ianm8/4020/README.md

# 4020
A dual band QRP transceiver for 40m and 20m. This project was described here: https://groups.io/g/qrptech/topic/designing_and_building_a/106295192

Here is a block diagram:

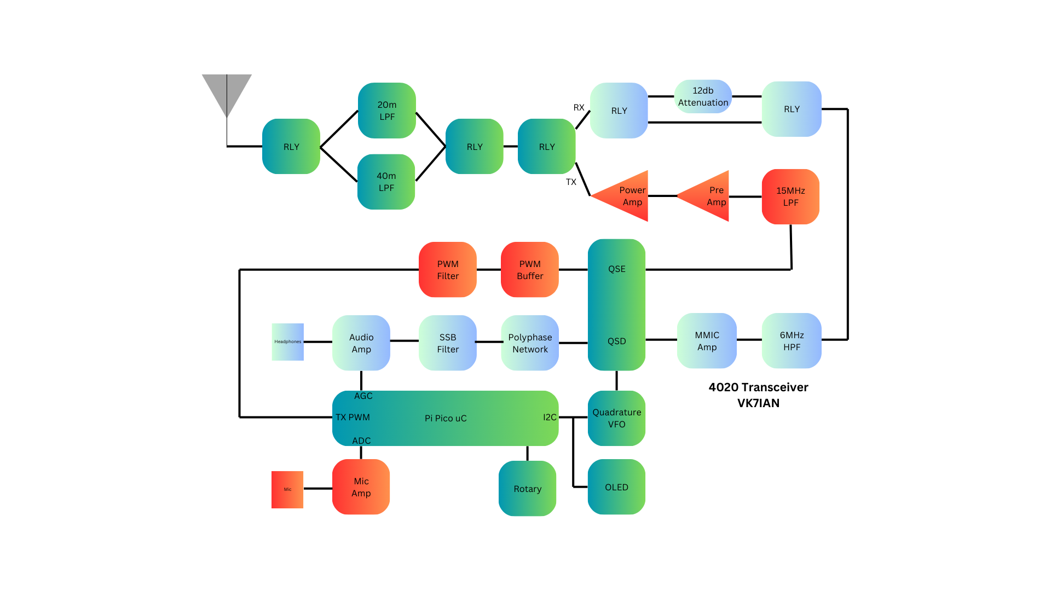
[picture p1: docs/4020-Block-Diagram.png]


And here is a block diagram of the transmit DSP:

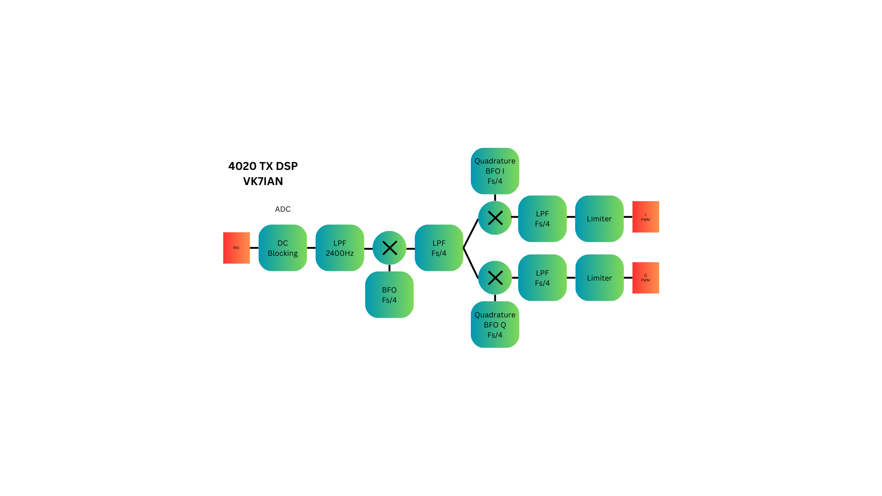
[picture p2: docs/4020 TX DSP.png]


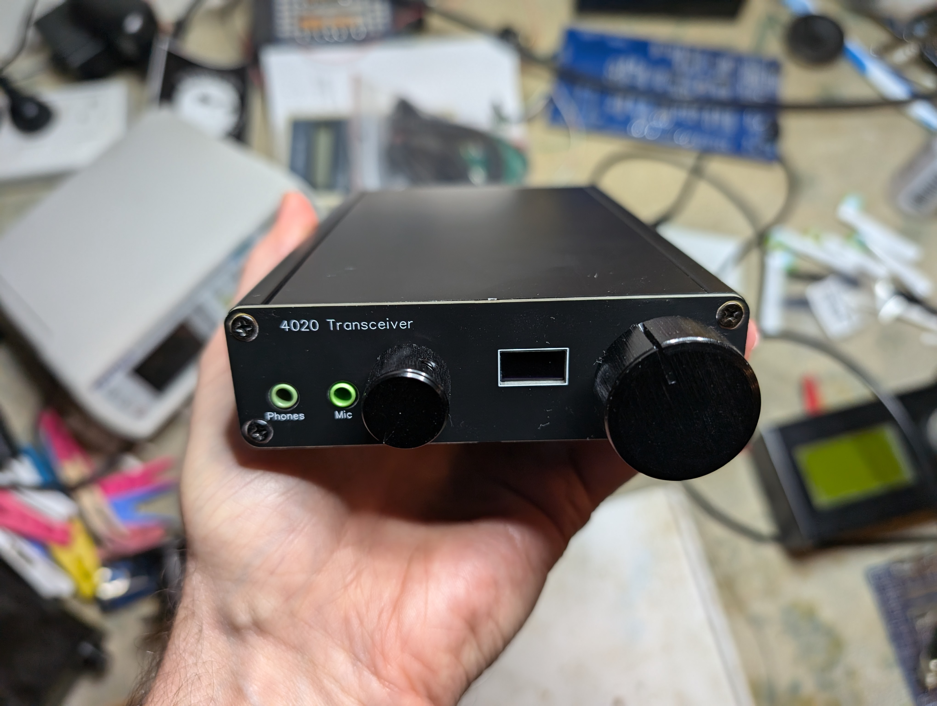
[picture p3: docs/4020-Complete.jpg]
