ianm8/4020/docs/4020 TX DSP.pdf

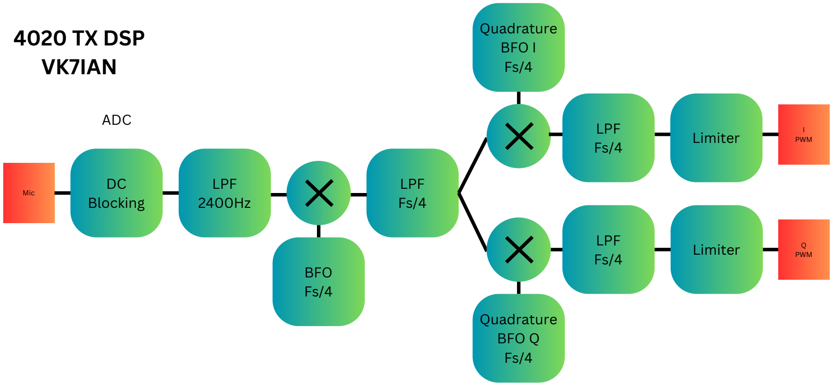
[picture p4: figure]
DC Blocking; Mic; LPF Fs/4; Quadrature BFO I Fs/4; LPF 2400Hz; BFO Fs/4; ADC; 4020 TX DSP VK7IAN; Quadrature BFO Q Fs/4; LPF; Limiter; PWMQ; PWM
