ianm8/4020/docs/4020-Block-Diagram.pdf

RLY

20m
LPF

40m
LPF
RLY | RLY
RLY | RLY

12db
Attenuation

QSE

QSD

15MHz
LPF

PWM
Buffer

Polyphase
Network

SSB
Filter

Audio
Amp

Headphones

Power
Amp

Pre
Amp

Quadrature
VFO
TX PWM | Pi Pico uC | I2C

Mic
Amp Mic

ADC

Rotary | OLED

AGC

RX

TX

PWM
Filter

## 4020 Transceiver VK7IAN

6MHz
HPF

MMIC
Amp
