ianm8/4020/src/V1/README.md

## To build in Arduino IDE

### Under Tools, set:
* Board: Raspberry Pi Pico
* CPU speed to 225MHz
* Optimize More (-O2)
* USB Stack: No USB
