ianm8/4020/docs/4020 FIR LPF Fs2.png

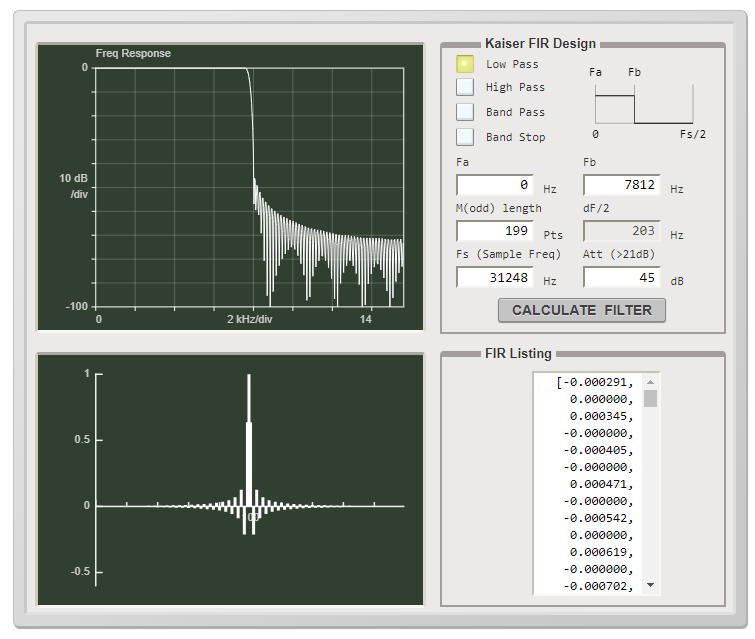
docs/4020 FIR LPF Fs2.png
