ianm8/4020/docs/4020 PCB 3D V1.png

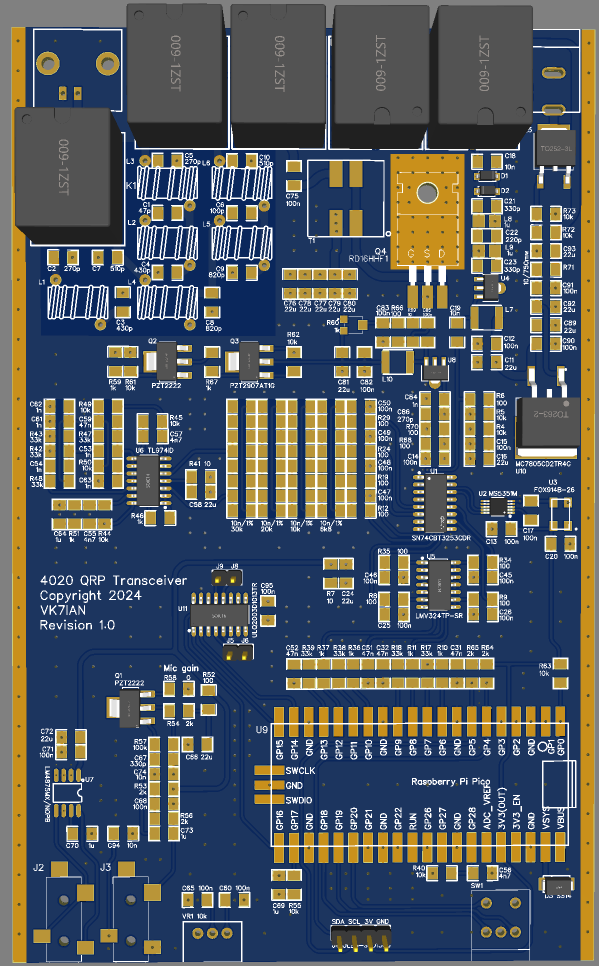
docs/4020 PCB 3D V1.png
