ianm8/4020/docs/4020 PCB Bottom.jpg

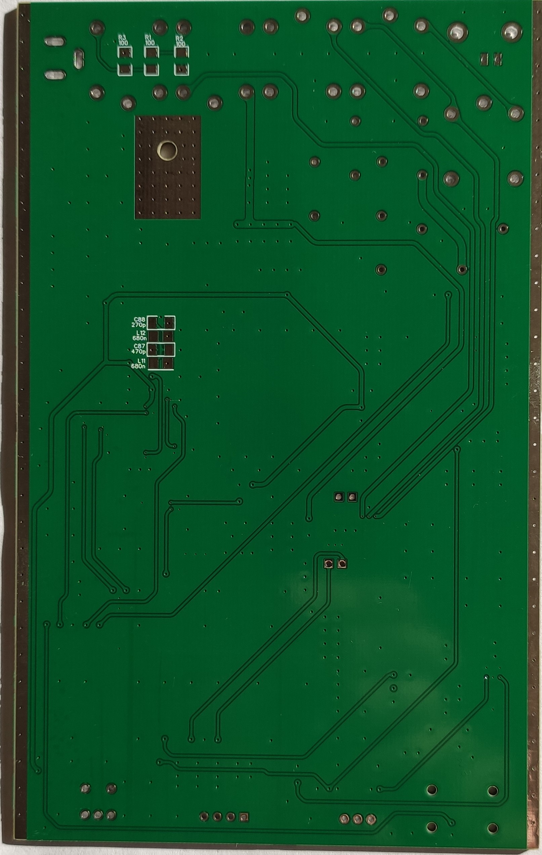
docs/4020 PCB Bottom.jpg
