ianm8/4020/docs/4020 PCB TOP.jpg

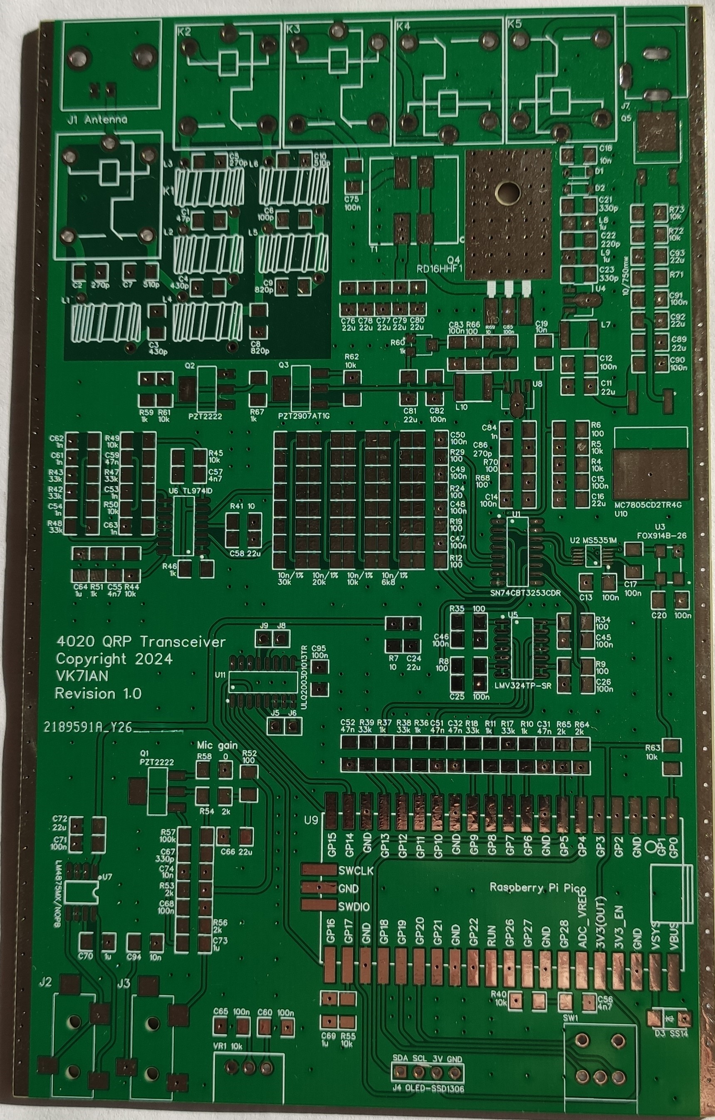
docs/4020 PCB TOP.jpg
