ianm8/4020/docs/4020 Poly Calc.png

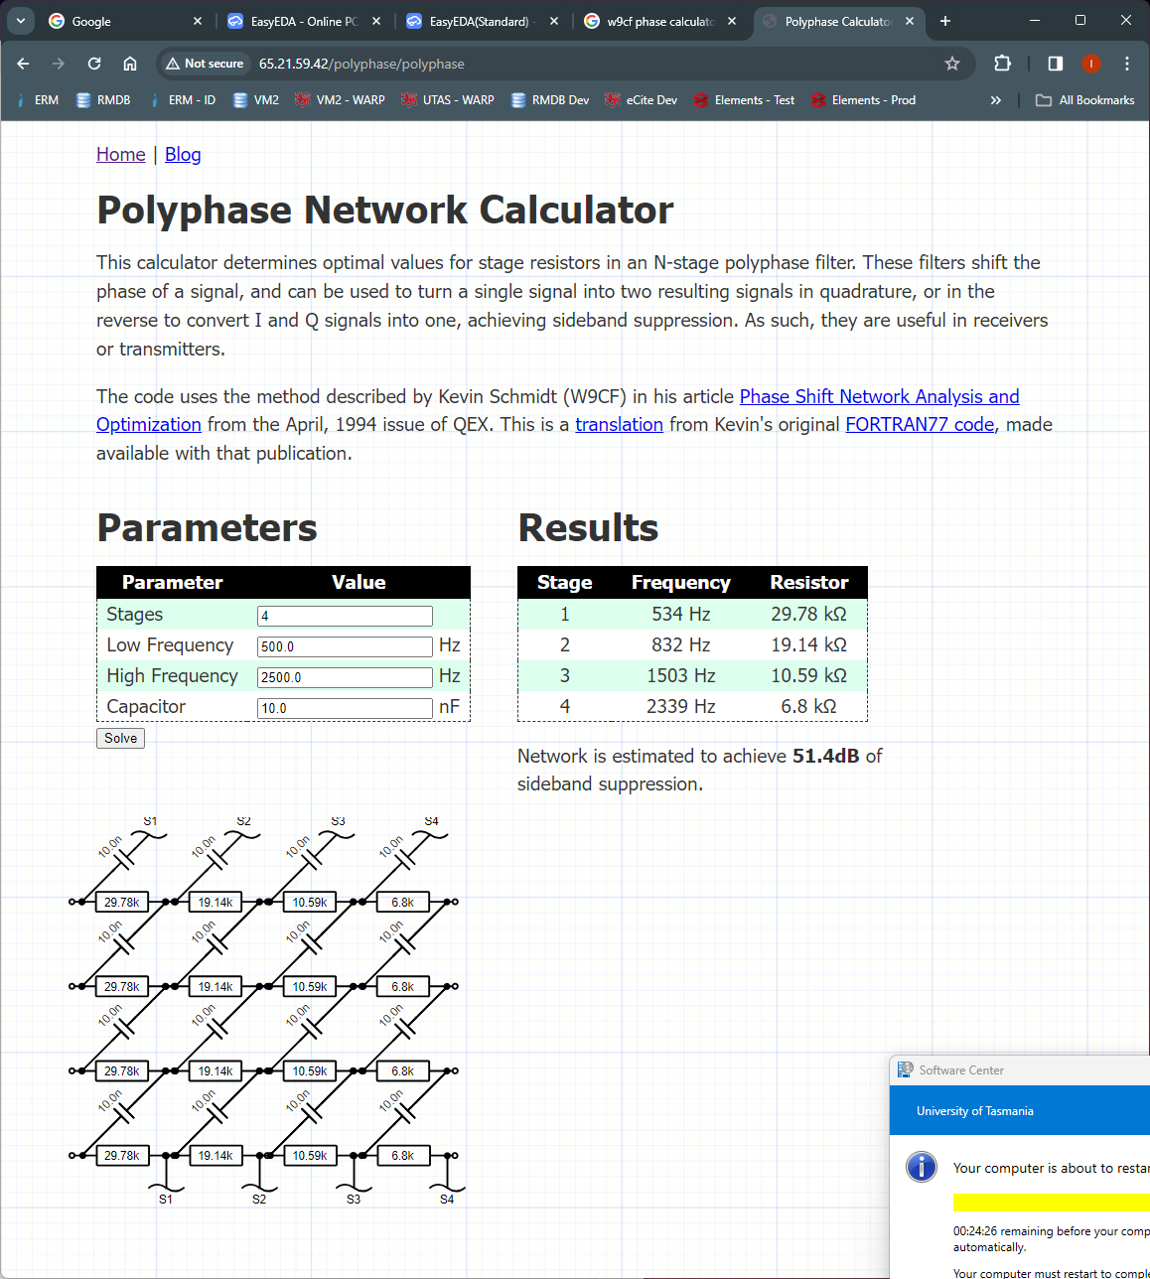
docs/4020 Poly Calc.png
