ianm8/4020/docs/4020 PWM Sim 2.png

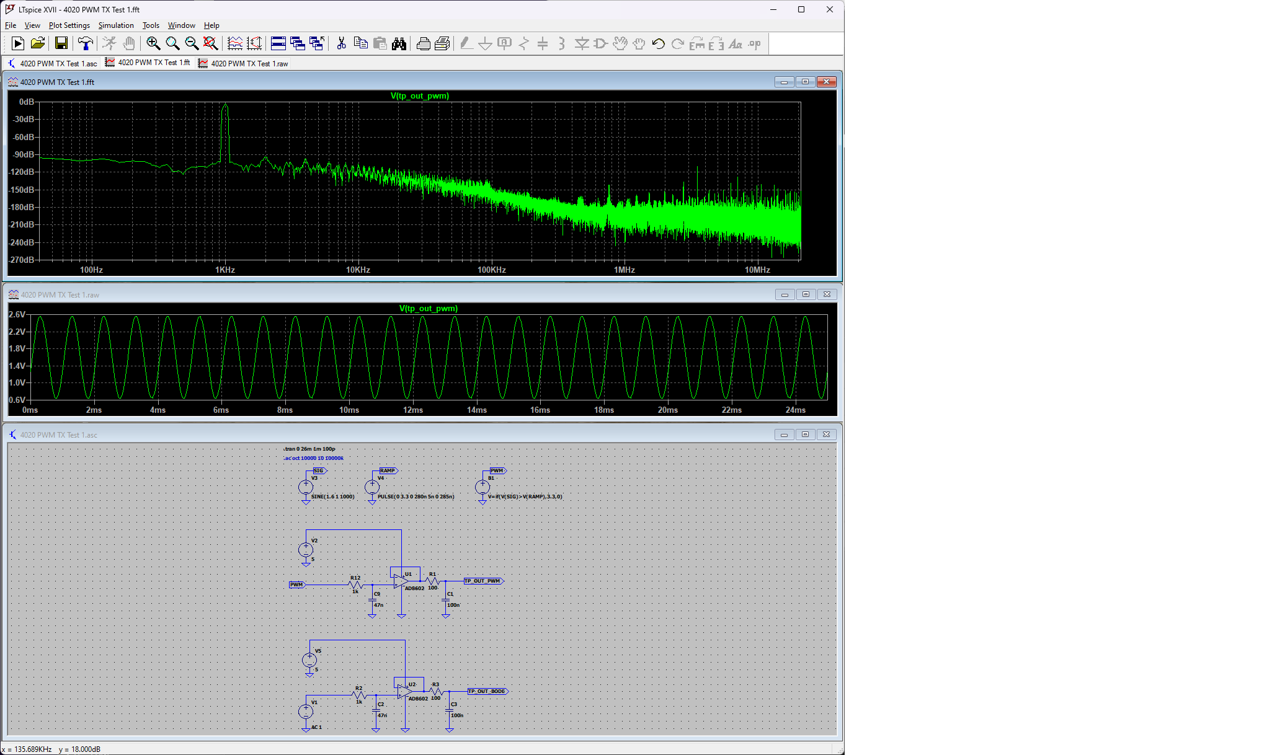
docs/4020 PWM Sim 2.png
