ianm8/4020/docs/4020 QSE 1.png

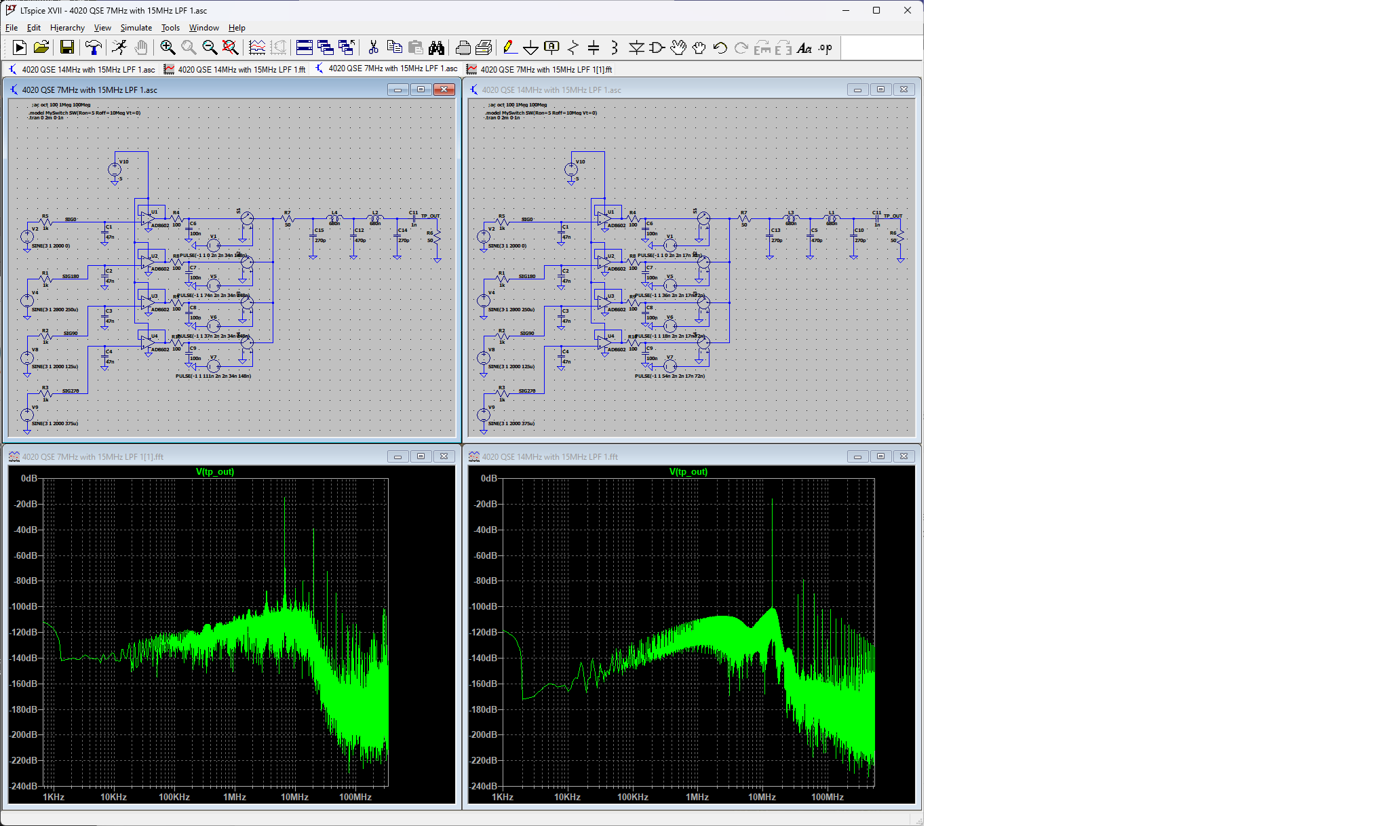
docs/4020 QSE 1.png
