ianm8/4020/docs/4020 SSB Filter Sim.png

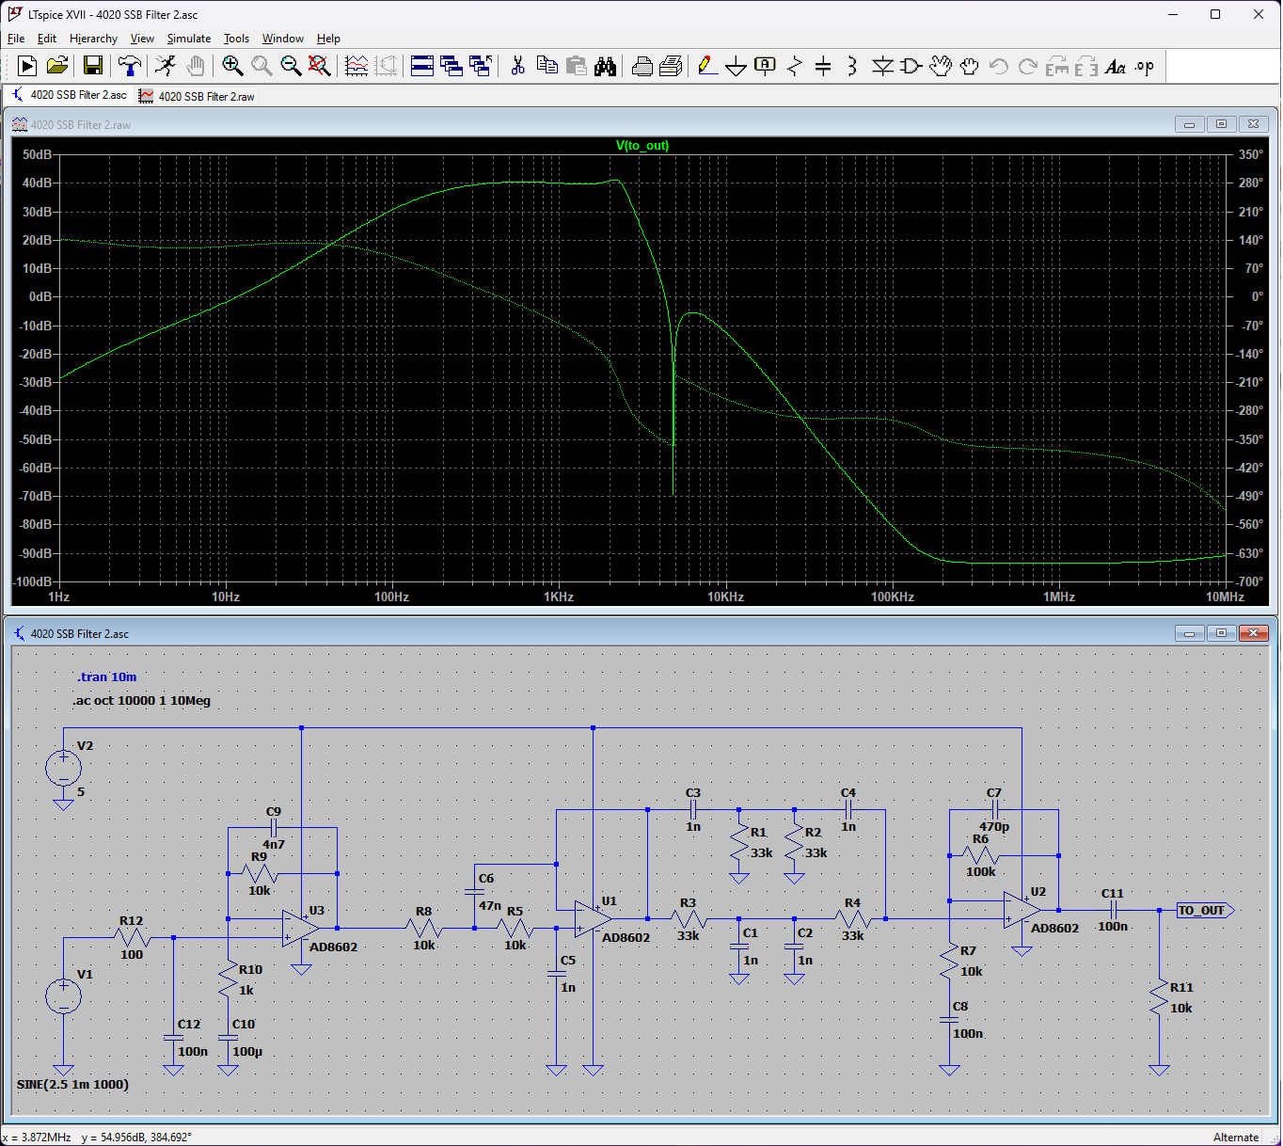
docs/4020 SSB Filter Sim.png
