ianm8/4020/docs/4020-QSD-Sim-1.png

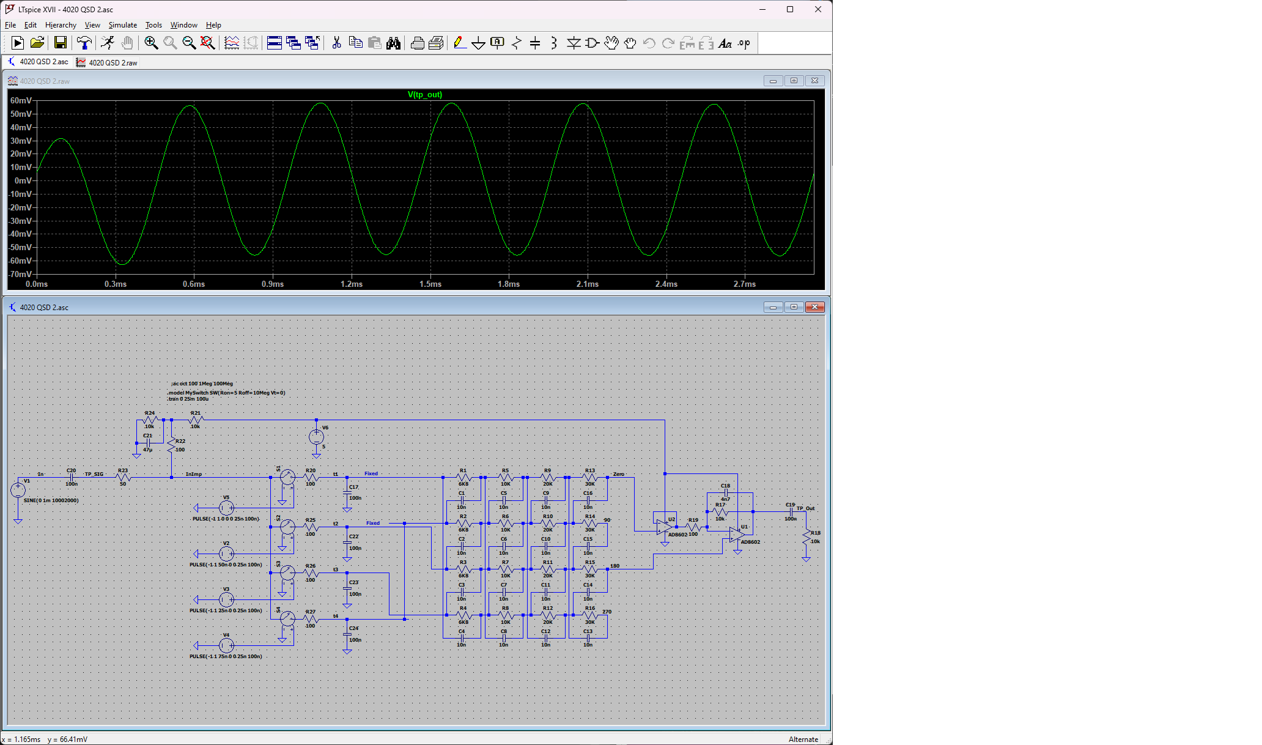
docs/4020-QSD-Sim-1.png
