ianm8/4020/docs/4020-Schematic-1v1-2024-06-23.png

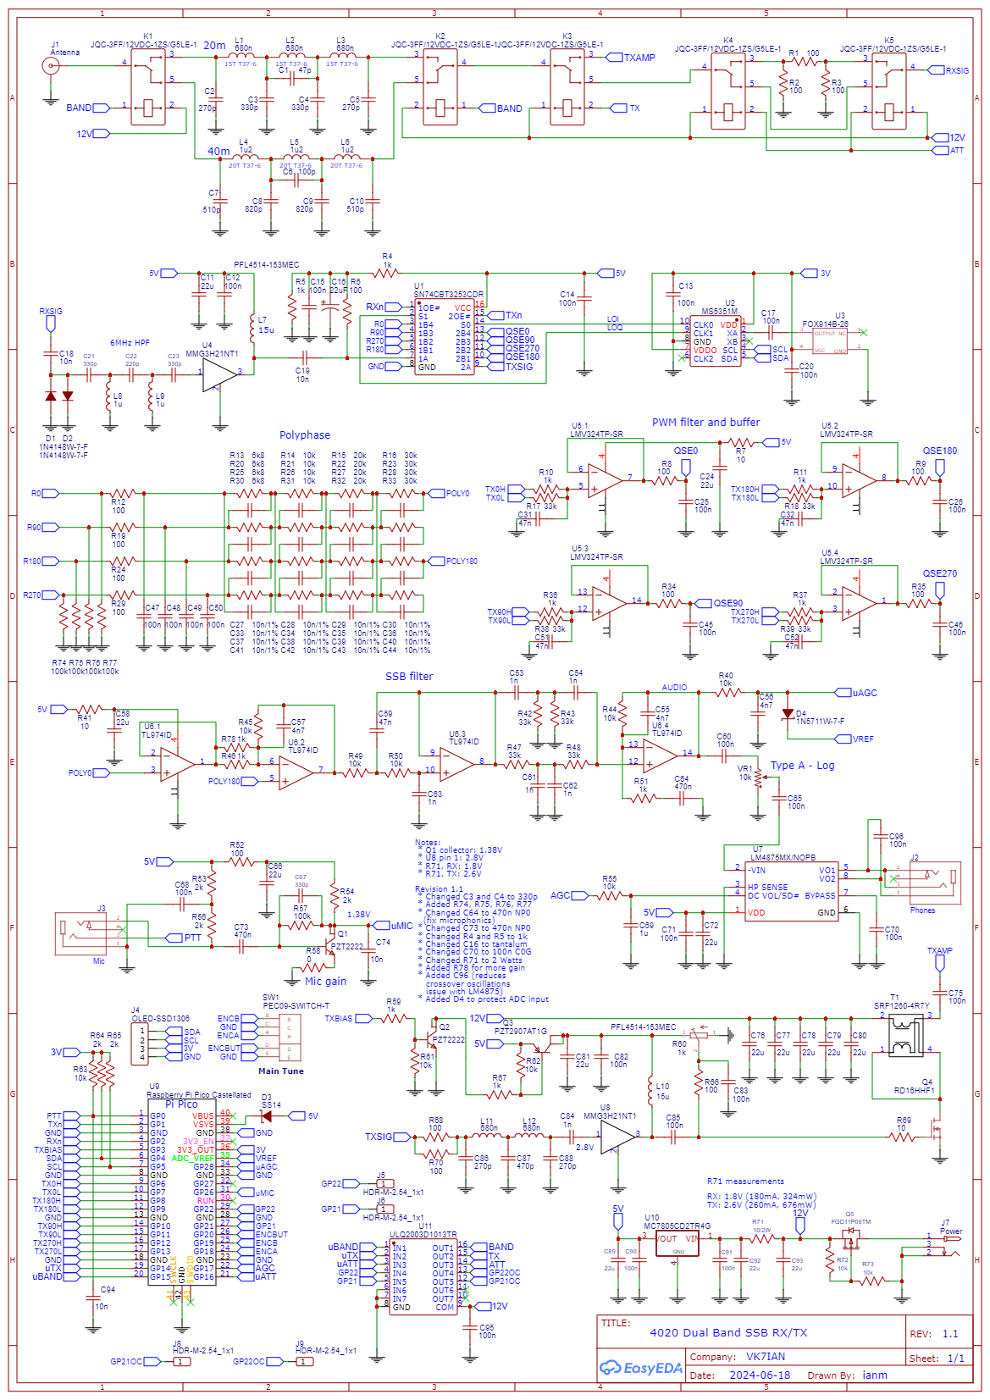
docs/4020-Schematic-1v1-2024-06-23.png
