ianm8/4020/docs/4040 Phase Shift.png

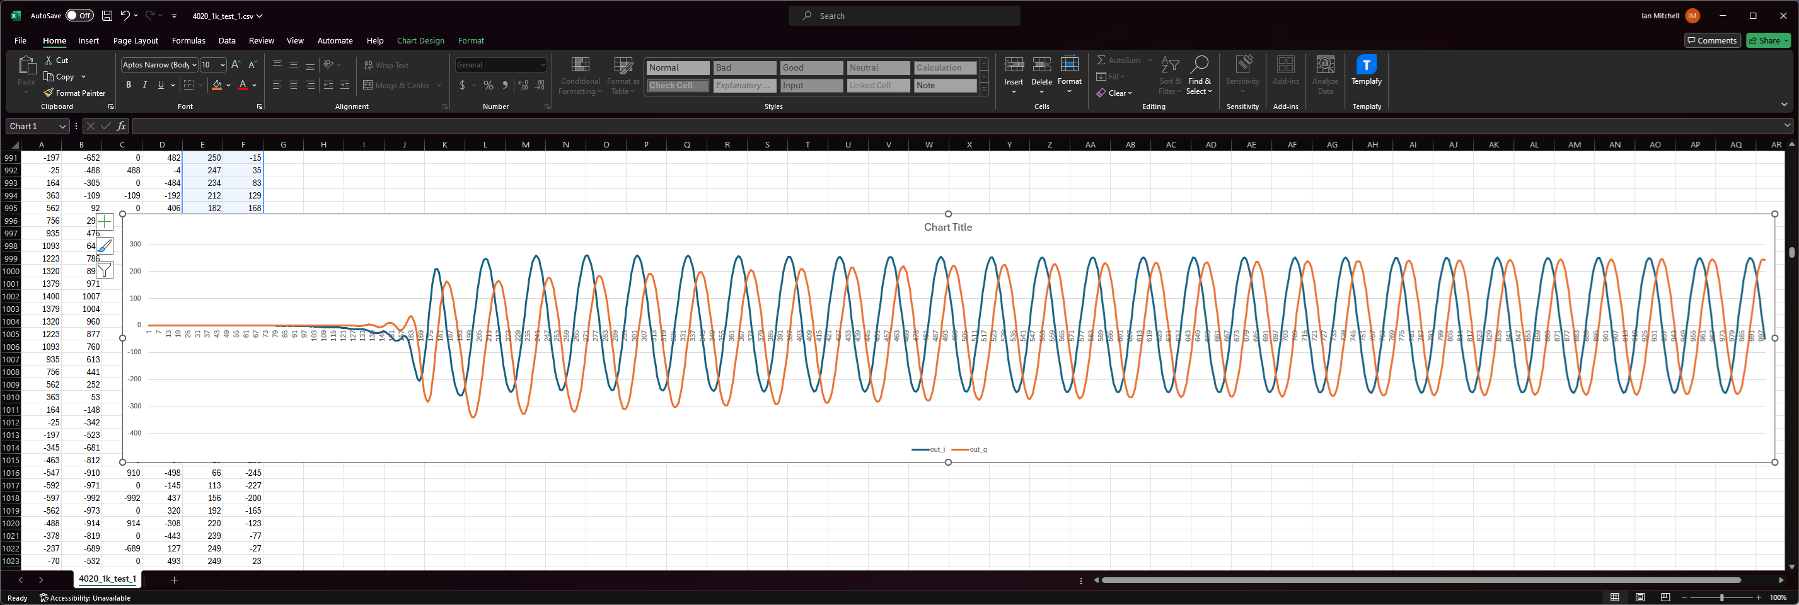
docs/4040 Phase Shift.png
