ianm8/4020/docs/4020_1k_Test_Data.csv

sig | lpf2400 | lo1 | lpf_fs4 | out_i | out_q
1400 | -1 | -1 | 0 | 0 | 0
1379 | -1 | 0 | 0 | 0 | 0
1320 | -1 | 1 | -1 | -1 | 0
1223 | -1 | 0 | 0 | 0 | 0
1093 | -1 | -1 | 0 | 0 | 0
935 | -1 | 0 | 0 | 0 | 0
756 | -1 | 1 | -1 | -1 | 0
562 | 0 | 0 | 0 | 0 | 0
363 | 1 | 1 | 0 | 0 | 0
164 | 1 | 0 | 0 | 0 | 0
-25 | 2 | -2 | -1 | 0 | 0
-197 | 1 | 0 | 0 | 0 | 0
-345 | 1 | 1 | 0 | 0 | 0
-463 | -1 | 0 | 0 | 0 | 0
-547 | -2 | 2 | -1 | 0 | 0
-592 | -4 | 0 | 0 | 0 | 0
-597 | -5 | -5 | 0 | 0 | 0
-562 | -5 | 0 | 0 | 0 | 0
-488 | -5 | 5 | -1 | 0 | 0
-378 | -3 | 0 | 0 | 0 | 0
-237 | 0 | 0 | 0 | 0 | 0
-70 | 4 | 0 | 0 | 0 | 0
115 | 6 | -6 | -1 | 0 | 0
313 | 8 | 0 | 0 | 0 | 0
512 | 8 | 8 | 0 | 0 | 0
709 | 5 | 0 | 0 | 0 | 0
892 | 1 | -1 | -1 | 0 | 0
1056 | -5 | 0 | 0 | 0 | 0
1193 | -11 | -11 | 0 | 0 | 0
1299 | -15 | 0 | 0 | 0 | 0
1368 | -16 | 16 | -1 | 0 | 0
1398 | -14 | 0 | 0 | 0 | 0
1388 | -8 | -8 | 0 | 0 | 0
1338 | 1 | 0 | 0 | 0 | 0
1250 | 11 | -11 | -1 | 0 | 0
1128 | 19 | 0 | 0 | 0 | 0
977 | 24 | 24 | 0 | 0 | 0
802 | 23 | 0 | 0 | 0 | 0
612 | 17 | -17 | -1 | 0 | 0
412 | 4 | 0 | 0 | 0 | 0
213 | -11 | -11 | 0 | 0 | 0
21 | -26 | 0 | 0 | 0 | 0
-156 | -38 | 38 | -1 | 0 | 0
-311 | -42 | 0 | 0 | 0 | 0
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
