ianm8/4020/docs/4020-Schematic-1v1-2024-06-23.pdf

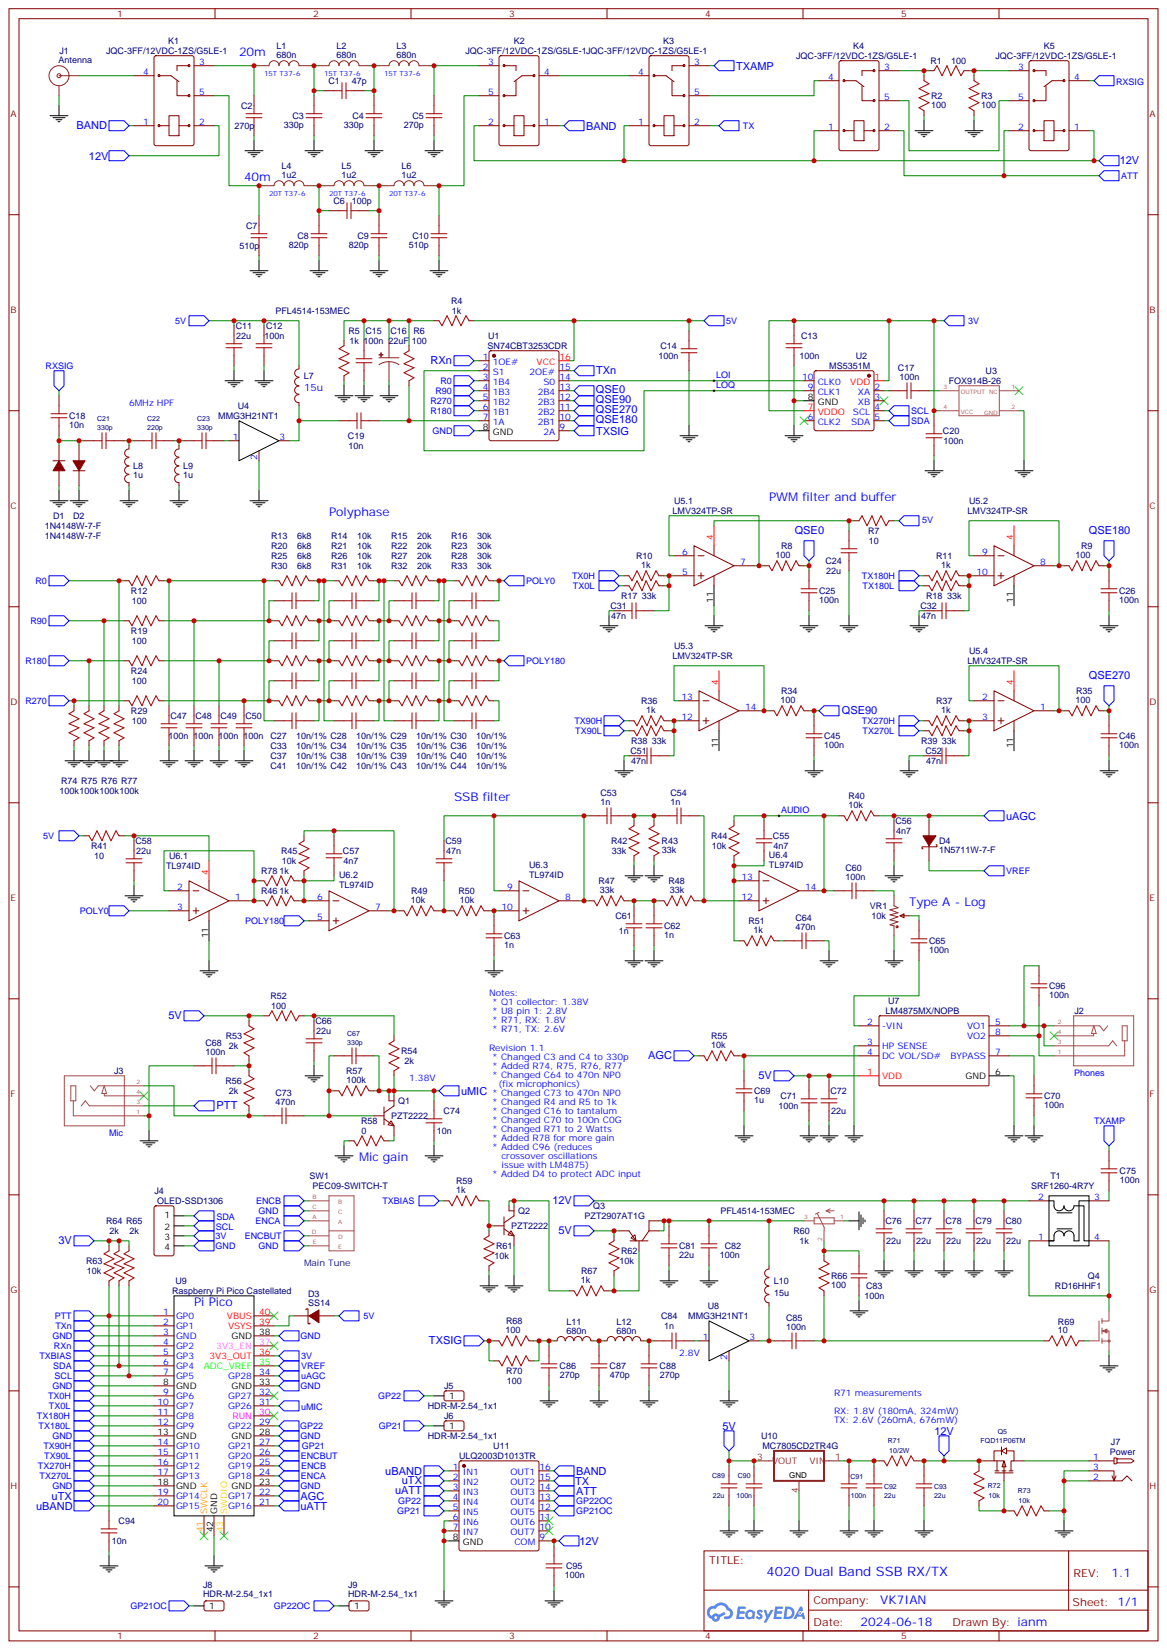
[picture p18: page 1]

PWM filter and buffer

Notes:
* Q1 collector: 1.38V
* U8 pin 1: 2.8V
Revision 1.1
* Changed C3 and C4 to 330p
* Added R74, R75, R76, R77
* Changed C64 to 470n NP0
(fix microphonics)
uMIC
* Changed C73 to 470n NP0
* Changed R4 and R5 to 1k
* Changed C16 to tantalum
* Changed C70 to 100n C0G
* Changed R71 to 2 Watts
* Added R78 for more gain
* Added C96 (reduces
crossover oscillations
issue with LM4875)
* Added D4 to protect ADC input

Raspberry Pi Pico Castellated
