ianm8/4020/docs/Schematic_4020-Version-1.pdf

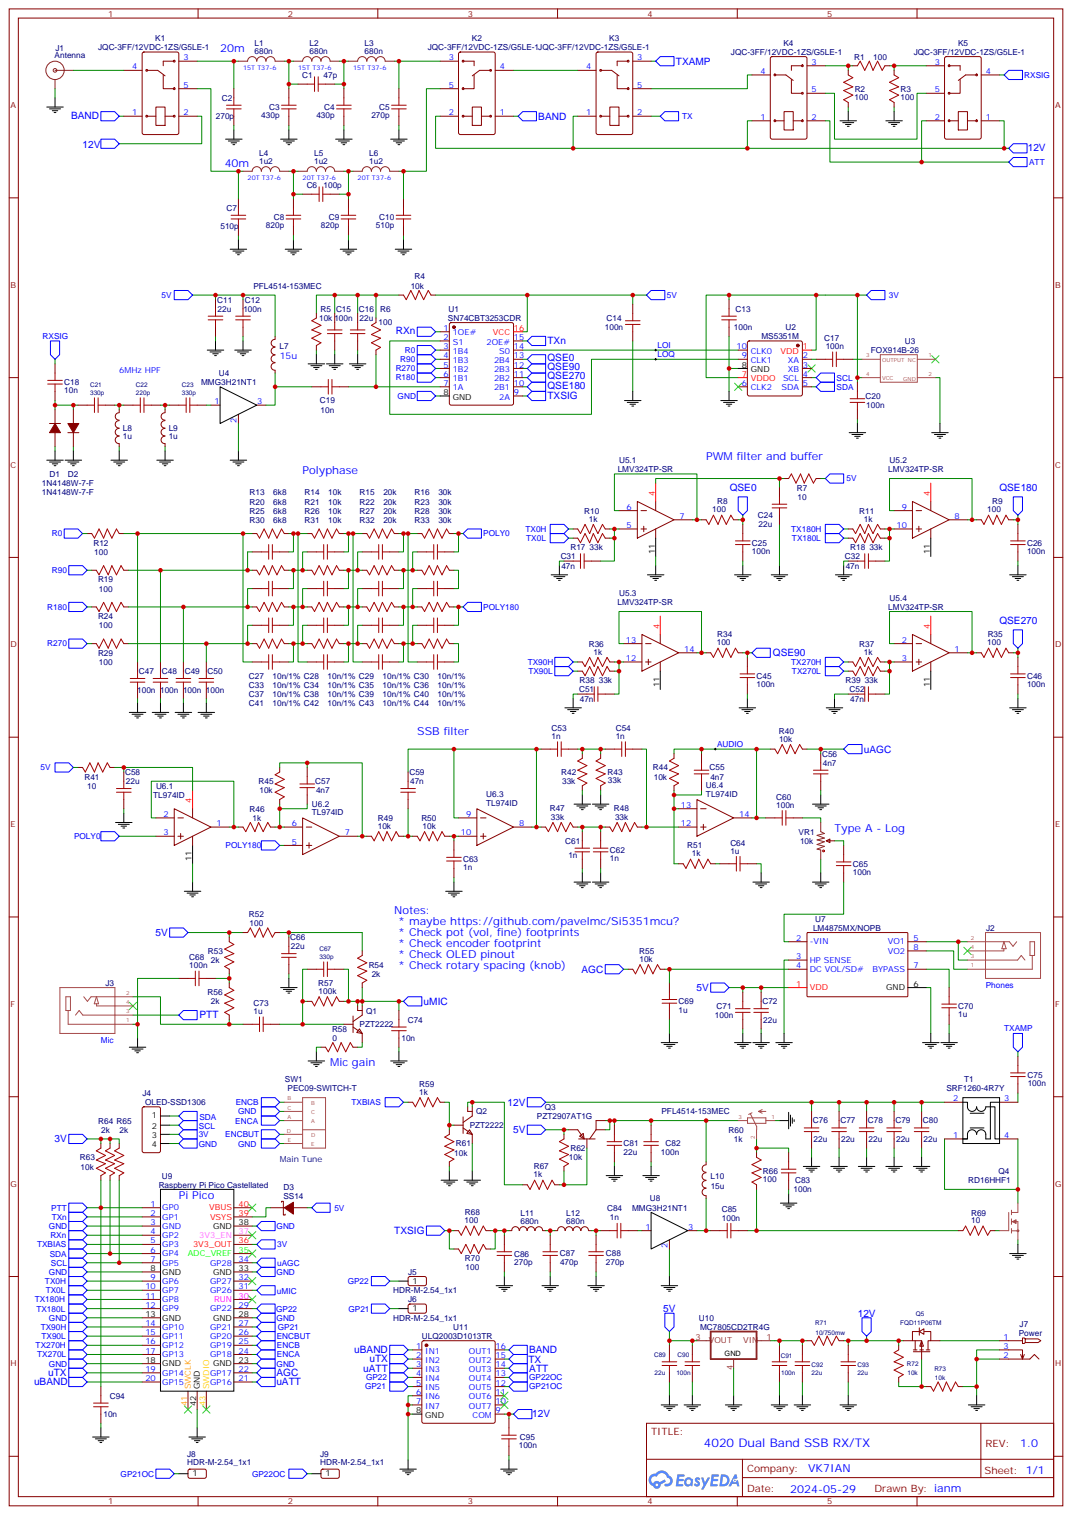
[picture p19: page 1]

PWM filter and buffer

Notes:
* maybe https://github.com/pavelmc/Si5351mcu?
* Check pot (vol, fine) footprints
* Check encoder footprint
* Check OLED pinout
* Check rotary spacing (knob)

Raspberry Pi Pico Castellated
