ianm8/4020/sims/4020 PWM TX Test 1.asc

B1: bv; V=if(V(SIG)>V(RAMP),3.3,0)
C1: cap; 100n
C2: cap; 47n
C3: cap; 100n
C9: cap; 47n
R1: res; 100
R2: res; 1k
R3: res; 100
R12: res; 1k
U1: AD8602
U2: AD8602
V1: voltage; ""; AC 1
V2: voltage; 5
V3: voltage; SINE(1.6 1 1000)
V4: voltage; PULSE(0 3.3 0 500n 5n 0 4.5u)
V5: voltage; 5
Named nets: 0, SIG, RAMP, PWM, TP_OUT_BODE, TP_OUT_PWM
.tran 0 26m 1m 1n
.ac oct 10000 10 10000k
