ianm8/4020/sims/4020 TX IRF510 7MHz 14MHz 7 Pole LPF Test 1.ASC

C1: cap; 820p
C2: cap; 820p
C3: cap; 510p
C4: cap; 510p
C5: cap; 100n
C6: cap; 100n
C7: cap; 270p
C8: cap; 430p
C9: cap; 430p
C10: cap; 270p
C11: cap; 18p
C27: cap; 100p
L1: ind; 1µ3; Rser=0.1
L2: ind; 1µ2; Rser=0.1
L3: ind; 1µ2; Rser=80m
L4: ind2; 10µ; Rser=14m
L5: ind; 680n
L6: ind2; 10µ; Rser=14m
L7: ind; 680n
L8: ind; 680n
M1: nmos; IRF510
R1: res; 10
Rload1: res; 50
Rload5: res; 50
V1: voltage; SINE(4.2 1 7.1Meg); Rser=1
V2: voltage; 13.8
V3: voltage; SINE(4.2 4 14.2Meg); Rser=1
Named nets: 0, TP_GATE_0, TP_15_MHz, TP_Drain, TP_OUT_7MHz
.tran 0 25u 5u
K1 L4 L6 1
13T T50-6
14MHz
7MHz
