ianm8/4020/sims/4020 - HPF 6MHz 1.asc

C1: cap; 330p
C2: cap; 220p
C3: cap; 330p
L1: ind; 1µ
L2: ind; 1µ
R1: res; 50
V1: voltage; SINE(0 10m 7Meg); AC 2; Rser=50
Named nets: 0, TP_Test
.ac oct 10000 100000 100Meg
