ianm8/4020/sims/4020 Audio Output Filter 1.asc

C1: cap; 100n
L1: ind; 100µ; Rser=16
L2: ind; 10µ
V1: voltage; SINE(0 10m 4Meg); AC 1; Rser=5
Named nets: 0, TP_OUT
.tran 1m
.ac oct 1000 10 10Meg
