ianm8/4020/sims/4020 Control 1.asc

D1: diode; 1N914
Q1: npn; 2N2222
Q2: npn; 2N2222
R1: res; 2.7k
R2: res; 7.2k
R3: res; 3k
R4: res; 10k
V1: voltage; 12
V2: voltage; PULSE(0 3.3 10m 0 0 0 20m 1)
V3: voltage; 5
Named nets: 0, TP_T1
.tran 50m
