ianm8/4020/sims/4020 LPF Bode 1.asc

C1: cap; 820p
C2: cap; 820p
C3: cap; 510p
C4: cap; 510p
C5: cap; 270p
C6: cap; 330p
C7: cap; 330p
C8: cap; 270p
C9: cap; 47p
C10: cap; 330p
C11: cap; 220p
C12: cap; 330p
C13: cap; 820p
C14: cap; 820p
C15: cap; 510p
C16: cap; 510p
C17: cap; 100p
C18: cap; 330p
C19: cap; 220p
C20: cap; 330p
C21: cap; 270p
C22: cap; 430p
C23: cap; 430p
C24: cap; 270p
C25: cap; 100p
C26: cap; 47p
C27: cap; 270p
C28: cap; 430p
C29: cap; 430p
C30: cap; 270p
C31: cap; 82p
C32: cap; 180p
C33: cap; 270p
C34: cap; 470p
C35: cap; 270p
C36: cap; 220p
C37: cap; 560p
C38: cap; 1n
C39: cap; 220p
C40: cap; 100n
C41: cap; 220p
C42: cap; 330p
C43: cap; 330p
C44: cap; 220p
C45: cap; 47p
C46: cap; 220p
C47: cap; 330p
C48: cap; 220p
C49: cap; 1n
L1: ind; 1µ2; Rser=80m
L2: ind; 1µ2; Rser=80m
L3: ind; 1µ2; Rser=80m
L4: ind; 680n
L5: ind; 680n
L6: ind; 680n
L7: ind; 1µ
L8: ind; 1µ
L9: ind; 1µ2; Rser=80m
L10: ind; 1µ2; Rser=80m
L11: ind; 1µ2; Rser=80m
L12: ind; 1µ
L13: ind; 1µ
L14: ind; 680n
L15: ind; 680n
L16: ind; 680n
L17: ind; 680n
L18: ind; 680n
L19: ind; 680n
L20: ind; 680n
L21: ind; 680n
L22: ind; 550n
L23: ind; 550n
L24: ind; 680n
L25: ind; 610n
L26: ind; 680n
L27: ind; 680n
L28: ind; 680n
Rin1: res; 50
Rin2: res; 50
Rin3: res; 50
Rin4: res; 50
Rin5: res; 50
Rin6: res; 50
Rin7: res; 50
Rload1: res; 50
Rload2: res; 50
Rload3: res; 50
Rload4: res; 50
Rload5: res; 50
Rload6: res; 50
Rload7: res; 50
Rload8: res; 50
Rload9: res; 50
V1: voltage; SINE(0 10m 7Meg); AC 2; Rser=50
V2: voltage; SINE(0 63 7.1Meg); AC 2
V3: voltage; SINE(0 63 14Meg); AC 2
V4: voltage; SINE(0 10m 7Meg); AC 2; Rser=50
V5: voltage; SINE(0 30 28Meg); AC 2
V6: voltage; SINE(0 30 28Meg); AC 2
V7: voltage; SINE(0 30 28Meg); AC 2
V8: voltage; SINE(0 63 14Meg); AC 2
V9: voltage; SINE(0 30 28Meg); AC 2
Named nets: 0, TP_OUT_7MHz, TP_4020_15_MHz, TP_OUT2_7MHz, TP_OUT2_15_MHz, TP_40_20_M, TP_TX_Filter_15M, TP_BITX20, TP_PSSSST_15_MHz, TP_TX_Filter_Prop_15M
15T T37-6
.ac oct 10000 1Meg 100Meg
.tran 10u
20T T37-6
20T T37-6
15T T37-6
15T T37-6
15T T37-6
15T T37-6
15T T37-6
15T T37-6
