ianm8/4020/sims/4020 NPN Mic Amp 1.asc

C1: cap; 1µ
C2: cap; 47µ
C3: cap; 10n
C4: cap; 100n
C5: cap; 330p
Q1: npn; 2N2222
R1: res; 100k
R2: res; 1
R5: res; 100
R6: res; 10k
R8: res; 2k
V1: voltage; SINE(0 25m 1k); AC 1 0; Rser=2k
V2: voltage; 5
Named nets: 0, TP_Out, TP_Sig_In
.tran 0 100m 0 100n
.ac oct 10000 1 100K
