ianm8/4020/sims/4020 PWM AGC 1.asc

B1: bv; V=if(V(AGC)>V(RAMP),3.3,0)
C1: cap; 1µ
C6: cap; 1µ
R1: res; 100k
R2: res; 10k
R5: res; 100k
R6: res; 10k
V1: voltage; PULSE(0 3.3 10m 0 0 1s 2s)
V3: voltage; 3.2
V4: voltage; PULSE(0 3.3 0 1.9u 0.1u 0 2u)
Named nets: 0, TP_OUT, AGC, RAMP, PWM, TP_OUT_2
.tran 0 10s 1m
.ac oct 10000 10 10000k
