ianm8/4020/sims/4020 QSD 1.asc

C1: cap; 10n
C2: cap; 10n
C3: cap; 10n
C4: cap; 10n
C5: cap; 10n
C6: cap; 10n
C7: cap; 10n
C8: cap; 10n
C9: cap; 10n
C10: cap; 10n
C11: cap; 10n
C12: cap; 10n
C13: cap; 10n
C14: cap; 10n
C15: cap; 10n
C16: cap; 10n
C17: cap; 100n
C18: cap; 4n7
C19: cap; 100n
C20: cap; 100n
C21: cap; 47µ
C22: cap; 100n
C23: cap; 100n
C24: cap; 100n
R1: res; 6K8
R2: res; 6K8
R3: res; 6K8
R4: res; 6K8
R5: res; 10K
R6: res; 10K
R7: res; 10K
R8: res; 10K
R9: res; 20K
R10: res; 20K
R11: res; 20K
R12: res; 20K
R13: res; 30K
R14: res; 30K
R15: res; 30K
R16: res; 30K
R17: res; 10k
R18: res; 10k
R19: res; 100
R20: res; 100
R21: res; 10k
R22: res; 100
R23: res; 50
R24: res; 10k
R25: res; 100
R26: res; 100
R27: res; 100
S1: sw; ""
S2: sw; ""
S3: sw; ""
S4: sw; ""
U1: AD8602
U2: AD8602
V1: voltage; SINE(0 1m 9998000); AC 1
V2: voltage; PULSE(-1 1 50n 0 0 25n 100n)
V3: voltage; PULSE(-1 1 25n 0 0 25n 100n)
V4: voltage; PULSE(-1 1 75n 0 0 25n 100n)
V5: voltage; PULSE(-1 1 0 0 0 25n 100n)
V6: voltage; 5
Named nets: Zero, 90, 180, 270, 0, TP_Out, t1, t2, t3, t4, InImp, In, TP_SIG
.tran 0 25m 100u
.model MySwitch SW(Ron=5 Roff=10Meg Vt=0)
;ac oct 100 1Meg 100Meg
