ianm8/4020/sims/4020 QSE 1.asc

C1: cap; 47n
C2: cap; 47n
C3: cap; 47n
C4: cap; 47n
C6: cap; 100n
C7: cap; 100n
C8: cap; 100n
C9: cap; 100n
C11: cap; 100n
C12: cap; 130p
C13: cap; 130p
L4: ind; 300n
R1: res; 1k
R2: res; 1k
R3: res; 1k
R4: res; 100
R5: res; 1k
R6: res; 50
R7: res; 50
R8: res; 100
R9: res; 100
R10: res; 100
S1: sw; ""
S2: sw; ""
S3: sw; ""
S4: sw; ""
U1: AD8602
U2: AD8602
U3: AD8602
U4: AD8602
V1: voltage; PULSE(-1 1 0 2n 2n 34n 144n)
V2: voltage; SINE(1.6 1 2000 0); AC 1
V4: voltage; SINE(1.6 1 2000 250u); AC 1
V5: voltage; PULSE(-1 1 72n 2n 2n 34n 144n)
V6: voltage; PULSE(-1 1 36n 2n 2n 34n 144n)
V7: voltage; PULSE(-1 1 108n 2n 2n 34n 144n)
V8: voltage; SINE(1.6 1 2000 125u); AC 1
V9: voltage; SINE(1.6 1 2000 375u); AC 1
V10: voltage; 5
Named nets: 0, SIG0, SIG180, SIG90, SIG270, TP_OUT
.tran 2m
.model MySwitch SW(Ron=5 Roff=10Meg Vt=0)
;ac oct 100 1Meg 100Meg
