ianm8/4020/sims/4020 QSE 3.5MHz with 10MHz LPF 1.asc

C1: cap; 47n
C2: cap; 47n
C3: cap; 47n
C4: cap; 47n
C5: cap; 1n
C6: cap; 100n
C7: cap; 100n
C8: cap; 100n
C9: cap; 100n
C10: cap; 560p
C11: cap; 100n
C13: cap; 560p
L1: ind; 1µ5
L3: ind; 1µ5
R1: res; 1k
R2: res; 1k
R3: res; 1k
R4: res; 100
R5: res; 1k
R6: res; 50
R7: res; 50
R8: res; 100
R9: res; 100
R10: res; 100
S1: sw; ""
S2: sw; ""
S3: sw; ""
S4: sw; ""
U1: AD8602
U2: AD8602
U3: AD8602
U4: AD8602
V1: voltage; PULSE(-1 1 0 0 0 68n 272n)
V2: voltage; SINE(3 1 2000 0); AC 1
V4: voltage; SINE(3 1 2000 250u); AC 1
V5: voltage; PULSE(-1 1 136n 0 0 68n 272n)
V6: voltage; PULSE(-1 1 68n 0 0 68n 272n)
V7: voltage; PULSE(-1 1 204n 0 0 68n 272n)
V8: voltage; SINE(3 1 2000 125u); AC 1
V9: voltage; SINE(3 1 2000 375u); AC 1
V10: voltage; 5
Named nets: 0, SIG0, SIG180, SIG90, SIG270, TP_OUT
.tran 0 2m 0 100p
.model MySwitch SW(Ron=5 Roff=10Meg Vt=0)
;ac oct 100 1Meg 100Meg
20T T37-6
