ianm8/4020/sims/4020 Relay Control 1.asc

D1: diode; 1N914
L1: ind; 2; Rser=340
Q2: npn; 2N3904
R4: res; 1k
R5: res; 10k
V1: voltage; 12
V2: voltage; PULSE(0 3.3 10m 0 0 100m 200m 2)
Named nets: 0, TP_RLY
.tran 500m
