ianm8/4020/sims/4020 SSB Filter 1.asc

C1: cap; 1n
C2: cap; 1n
C3: cap; 1n
C4: cap; 1n
C5: cap; 1n
C6: cap; 47n
C7: cap; 4n7
C8: cap; 470n
C9: cap; 4n7
C10: cap; 100µ
C11: cap; 100n
C12: cap; 100n
R1: res; 33k
R2: res; 33k
R3: res; 33k
R4: res; 33k
R5: res; 10k
R6: res; 10k
R7: res; 1k
R8: res; 10k
R9: res; 10k
R10: res; 1k
R11: res; 10k
R12: res; 100
U1: AD8602
U2: AD8602
U3: AD8602
V1: voltage; SINE(2.5 1m 1000); AC 1
V2: voltage; 5
Named nets: 0, TO_OUT
.ac oct 10000 100 10k
.tran 10m
