ianm8/4020/sims/4020 SWR 1.asc

C1: cap; 10n
C2: cap; 100n
C3: cap; 10n
C4: cap; 10n
C5: cap; 10n
C6: cap; 1p
D1: diode; 1N914
D2: schottky; 1N5711
L1: ind2; 0.35µ
L2: ind2; 22µ
L3: ind2; 22µ
L4: ind2; 0.35µ
R1: res; 50
R2: res; 50
R3: res; 50
R4: res; 100k
R5: res; 100k
R6: res; 10k
R7: res; 10k
R8: res; 0.01
U1: LT1677
U2: LT1677
V1: voltage; SINE(0 50 3Meg); AC 2; Rser=50
V2: voltage; 5
Named nets: 0, antenna, trans, Vf, Vr, Tr, Tf, TP_F, TP_R, TP_Rev, TP_For
.tran 10m
K1 L1 L2 0.99
;ac oct 1000 100K 100Meg
K2 L3 L4 0.99
.MODEL 1N5711 D IS=5.5987E-9 N=1.0023 RS=30.053 IKF=19.036 CJO=1.7605E-12
+ M=.20029 VJ=.3905 ISR=24.229E-9 NR=4.1695 FC=0.5 TT=0 XTI=2
11u = x5
28u = x8
44u = x10
FT37-43 8:1 Turns
