ianm8/4020/sims/4020 TX Bias Control 1.asc

C1: cap; 10µ
Q1: pnp; 2N2907
Q2: npn; 2N3904
R1: res; 1k
R2: res; 1k
R3: res; 10k
R4: res; 1k
R5: res; 10k
V1: voltage; 5
V2: voltage; 0
Named nets: 0, TP_Bias
.tran 100m
