ianm8/4020/src/V3/mic.h

#ifndef DSP_H
#define DSP_H

#define FIR_LENGTH 256
#define __mac_tap(_h) acc += (_h)*x[i++]

static const int16_t __not_in_flash_func(lpf_2400)(const int16_t sample)
{
   // nominal 31250 sample rate
   static int32_t x[FIR_LENGTH] = { 0 };
   static uint8_t sample_index = 0;
   uint8_t i = sample_index;
   x[sample_index--] = sample;
   int32_t acc = 0;
   __mac_tap(-3);
   __mac_tap(-5);
   __mac_tap(-6);
   __mac_tap(-5);
   __mac_tap(-2);
   __mac_tap(2);
   __mac_tap(7);
   __mac_tap(12);
   __mac_tap(15);
   __mac_tap(14);
   __mac_tap(8);
   __mac_tap(-1);
   __mac_tap(-14);
   __mac_tap(-26);
   __mac_tap(-34);
   __mac_tap(-35);
   __mac_tap(-27);
   __mac_tap(-10);
   __mac_tap(14);
   __mac_tap(39);
   __mac_tap(59);
   __mac_tap(68);
   __mac_tap(60);
   __mac_tap(36);
   __mac_tap(-3);
   __mac_tap(-49);
   __mac_tap(-91);
   __mac_tap(-117);
   __mac_tap(-118);
   __mac_tap(-89);
   __mac_tap(-32);
   __mac_tap(42);
   __mac_tap(118);
   __mac_tap(177);
   __mac_tap(201);
   __mac_tap(177);
   __mac_tap(105);
   __mac_tap(-6);
   __mac_tap(-133);
   __mac_tap(-247);
   __mac_tap(-318);
   __mac_tap(-320);
   __mac_tap(-242);
   __mac_tap(-90);
   __mac_tap(109);
   __mac_tap(315);
   __mac_tap(476);
   __mac_tap(546);
   __mac_tap(489);
   __mac_tap(298);
   __mac_tap(-8);
   __mac_tap(-375);
   __mac_tap(-726);
   __mac_tap(-972);
   __mac_tap(-1026);
   __mac_tap(-824);
   __mac_tap(-338);
   __mac_tap(414);
   __mac_tap(1367);
   __mac_tap(2415);
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
   __mac_tap(-31);
   return (int16_t)(acc >> 15);
}

static const int16_t __not_in_flash_func(dc)(const int16_t in)
{
  static int32_t s = 0;
  static int32_t x1 = 0;
  static int16_t y1 = 0;
  s -= x1;
  x1 = (int32_t)in << 16;
  s += x1 - ((int32_t)y1 << 8);
  return (y1 = s >> 16);
}

const void __not_in_flash_func(process_mic)(const int16_t s,int16_t &out_i,int16_t &out_q,const uint8_t proc_level)
{
  // generate a quadrature version of the input signal
  // this is done by applying a local oscillator at one quarter
  // of the sample rate and low pass filtering, rather than a phase
  // shift FIR filter

  static uint32_t lo = 0;
  const uint8_t phase = lo & 0x03;

  // 2400Hz LPF
  const int16_t lpf2400 = lpf_2400(dc(s));

  // up convert to FS/4
  // note LO signal reduces to 0, 1 and -1 at FS/4
  int16_t v = 0;
  switch (phase)
  {
    case 0: v = +lpf2400; break;
    case 2: v = -lpf2400; break;
  }

  // remove the upper image
  // note with a LPF at FS/4 there are many zeros
  v = lpf_fs4_1(v);

  // mic processor
  if (proc_level)
  {
    // level 1: v = v * 1.25 (v + (v >> 2))
    // level 2: v = v * 1.5  (v + (v >> 1))
    // level 3: v = v * 2    (v + (v >> 0))
    const uint8_t mic_gain = 3-proc_level;
    v = v + (v>>mic_gain);
    v = constrain(v,-1024,+1023);
    v = lpf_fs4_2(v);
    v = hpf_fs8(v);
  }
  
  // LO to down convert in quadrature
  // note at FS/4 the LO signal reduces to 0, 1 and -1
  int16_t i = 0;
  int16_t q = 0;
  switch (phase)
  {
    case 0: i = +v; break;
    case 1: q = +v; break;
    case 2: i = -v; break;
    case 3: q = -v; break;
  }

  // remove the upper image with another FS/4 LPF
  out_i = lpf_fs4_i(i);
  out_q = lpf_fs4_q(q);

  lo++;
}

#endif
