ianm8/4020/src/V3/CW.h

#ifndef CW_H
#define CW_H

#define COS_SIN_TAB 125

namespace CW
{
  static const int16_t cos_tab[COS_SIN_TAB] =
  {
    511,
    501,
    470,
    421,
    354,
    274,
    182,
    83,
    -19,
    -121,
    -218,
    -306,
    -381,
    -441,
    -484,
    -507,
    -510,
    -492,
    -454,
    -398,
    -326,
    -241,
    -146,
    -45,
    58,
    158,
    252,
    336,
    406,
    460,
    495,
    510,
    505,
    480,
    435,
    373,
    295,
    206,
    108,
    6,
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
  };

  static const int16_t sin_tab[COS_SIN_TAB] =
  {
    0,
    102,
    200,
    290,
    368,
    431,
    477,
    504,
    511,
    497,
    462,
    410,
    340,
    257,
    164,
    64,
    -38,
    -139,
    -235,
    -321,
    -394,
    -451,
    -490,
    -509,
    -508,
    -486,
    -445,
    -385,
    -311,
    -223,
    -127,
    -26,
    77,
    176,
    268,
    350,
    417,
    468,
    499,
    511,
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
  };

  static const uint16_t gaussian_tab[312] =
  {
    32767,
    32765,
    32759,
    32748,
    32733,
    32714,
    32691,
    32664,
    32633,
    32597,
    32557,
    32513,
    32465,
    32413,
    32357,
    32297,
    32233,
    32165,
    32092,
    32016,
    31936,
    31852,
    31764,
    31673,
    31577,
    31478,
    31375,
    31269,
    31158,
    31045,
    30927,
    30806,
    30682,
    30554,
    30423,
    30289,
    30151,
    30010,
    29866,
    29718,
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
  };

  static void __not_in_flash_func(process_cw)(const bool keydown,const bool gaussian,int16_t &out_i,int16_t &out_q)
  {
    volatile static uint32_t phase = 0;
    volatile static uint32_t gaussian_phase = 0;
    if (gaussian)
    {
      volatile static enum cw_state_t
      {
        CW_STATE_KEYUP,
        CW_STATE_KEYDOWN,
        CW_STATE_KEY_TRANSITION_TO_DOWN,
        CW_STATE_KEY_TRANSITION_TO_UP
      }
      cw_state = CW_STATE_KEYUP;
      switch (cw_state)
      {
        case CW_STATE_KEYUP:
        {
          out_i = 0;
          out_q = 0;
          // if keydown then transition to key down
          if (keydown)
          {
            gaussian_phase = 311;
            cw_state = CW_STATE_KEY_TRANSITION_TO_DOWN;
          }
          break;
        }
        case CW_STATE_KEY_TRANSITION_TO_DOWN:
        {
          // stay here until gaussian done
          const int32_t gaussian = gaussian_tab[gaussian_phase];
          const int32_t sig_i = cos_tab[phase];
          const int32_t sig_q = sin_tab[phase];
          out_i = (sig_i * gaussian) >> 15;
          out_q = (sig_q * gaussian) >> 15;
          phase++;
          if (phase>=COS_SIN_TAB)
          {
            phase = 0;
          }
          gaussian_phase--;
          if (gaussian_phase==0)
          {
            cw_state = CW_STATE_KEYDOWN;
          }
          break;
        }
        case CW_STATE_KEYDOWN:
        {
          // stay here while key down
          out_i = cos_tab[phase];
          out_q = sin_tab[phase];
          phase++;
          if (phase>=COS_SIN_TAB)
          {
            phase = 0;
          }
          if (keydown)
          {
            return;
          }
          gaussian_phase = 0;
          cw_state = CW_STATE_KEY_TRANSITION_TO_UP;
          break;
        }
        case CW_STATE_KEY_TRANSITION_TO_UP:
        {
          // stay here until gaussian done
          const int32_t gaussian = gaussian_tab[gaussian_phase];
          const int32_t sig_i = cos_tab[phase];
          const int32_t sig_q = sin_tab[phase];
          out_i = (sig_i * gaussian) >> 15;
          out_q = (sig_q * gaussian) >> 15;
          phase++;
          if (phase>=COS_SIN_TAB)
          {
            phase = 0;
          }
          gaussian_phase++;
          if (gaussian_phase>=312)
          {
            cw_state = CW_STATE_KEYUP;
          }
          break;
        }
      }
    }
    else
    {
      // gaussian off
      if (keydown)
      {
        out_i = cos_tab[phase];
        out_q = sin_tab[phase];
        phase++;
        if (phase>=COS_SIN_TAB)
        {
          phase = 0;
        }
      }
      else
      {
        out_i = 0;
        out_q = 0;      
      }
    }
  }
}

#endif
