ianm8/4020/(commit log)

2024-05-27 Create 4020_1k_Test_Data.csv
    This is data output by the C test program 4020-TX-Test.cpp
    [4020_1k_Test_Data.csv]
2024-05-27 FIR lowpass filter at Fs/4
2024-05-28 LTSpice PWM
2024-06-03 Revision 1.0 PCB
2024-06-08 4020 PCB
2024-06-08 4020 PCB Top View
2024-06-08 4020 PCB Top
2024-06-19 Circuit Revision 1.1
2024-06-23 Delete src/Rotary.cpp
    Uploaded in the wrong place!
    [Rotary.cpp]
2024-06-23 Delete src/Rotary.h
    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
    [Rotary.h]
2024-06-23 Delete src/agc.h
    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
    [agc.h]
2024-06-23 Delete src/mic.h
    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
    [mic.h]
2024-06-23 Delete src/quad5351.h
    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
    [quad5351.h]
2024-06-24 3D View of PCB 1.1
    3D view of PCB version 1.1.
2024-07-19 Update 4020_V1.ino
    Fix issue with ADC FIFO.
    [4020_V1.ino]
2024-08-10 Fixed CW sidetone.
    Fixed bug with sidetone in CW transition to receive.
    [4020_V3_001.ino]
2024-08-16 Update 4020_V3_001.ino
    Flash LED if SI5351 not found.
2024-09-16 Process CW and process key.
    Switch names for process CW and process key which makes more sense.
